islam1900/B.G2024/v-photos/B.jpeg

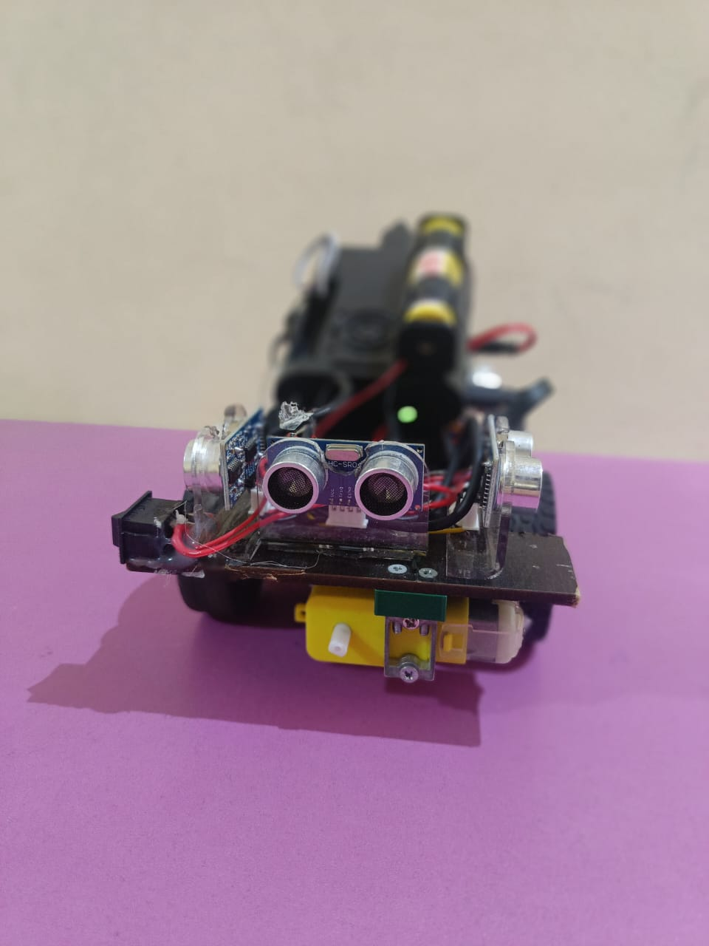
v-photos/B.jpeg
