islam1900/B.G2024/v-photos/R.jpeg

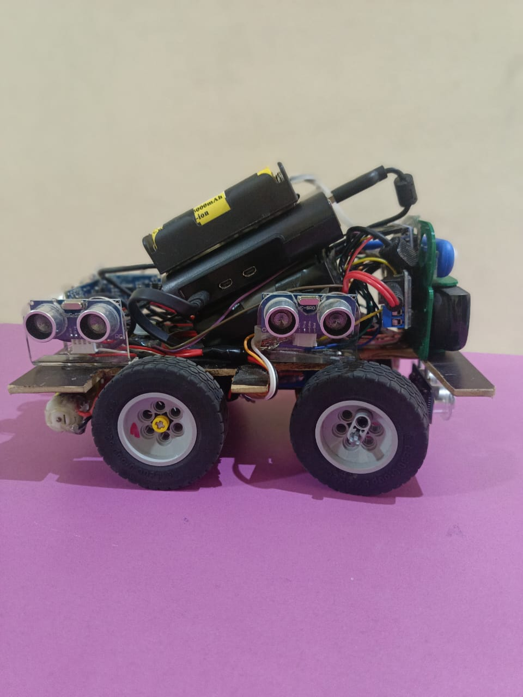
v-photos/R.jpeg
