islam1900/B.G2024/other/flow chart.jpeg

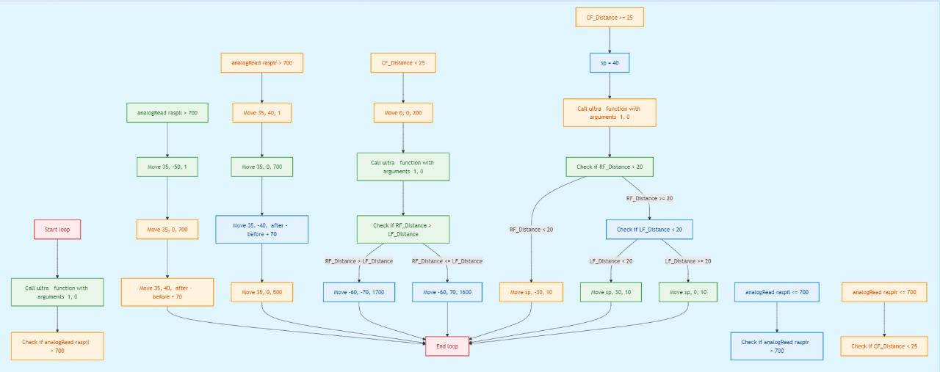
other/flow chart.jpeg
