islam1900/B.G2024/schemes/WhatsApp Image 2024-10-04 at 12.02.47 PM.jpeg

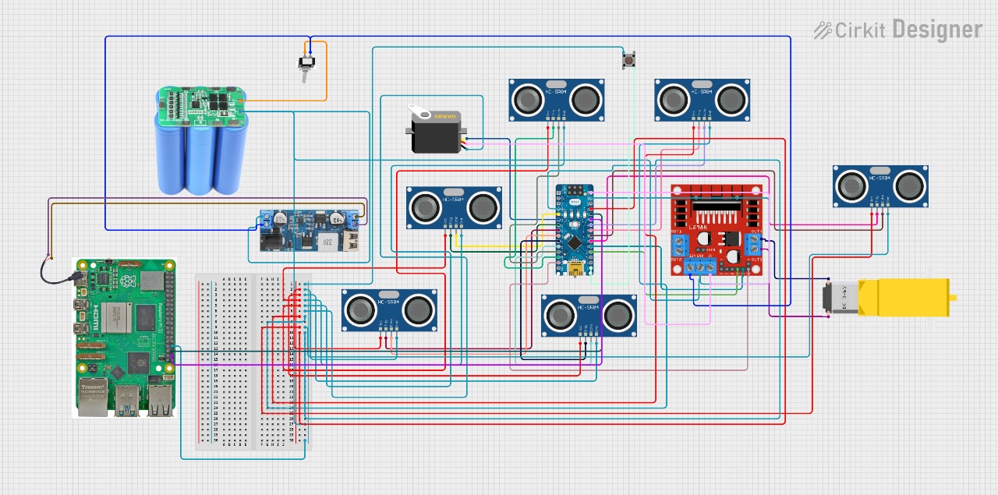
schemes/WhatsApp Image 2024-10-04 at 12.02.47 PM.jpeg
