islam1900/B.G2024/t-photos/WhatsApp Image 2024-10-04 at 3.51.35 PM.jpeg

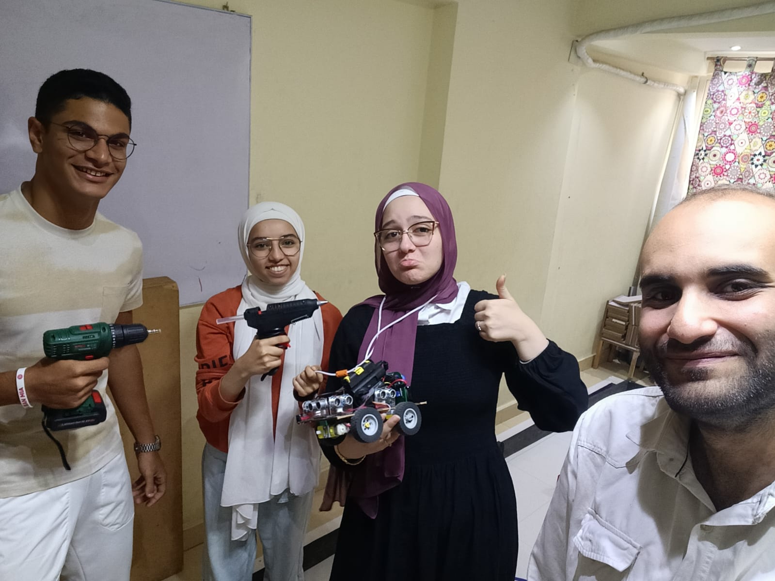
t-photos/WhatsApp Image 2024-10-04 at 3.51.35 PM.jpeg
