islam1900/B.G2024/v-photos/D.jpeg

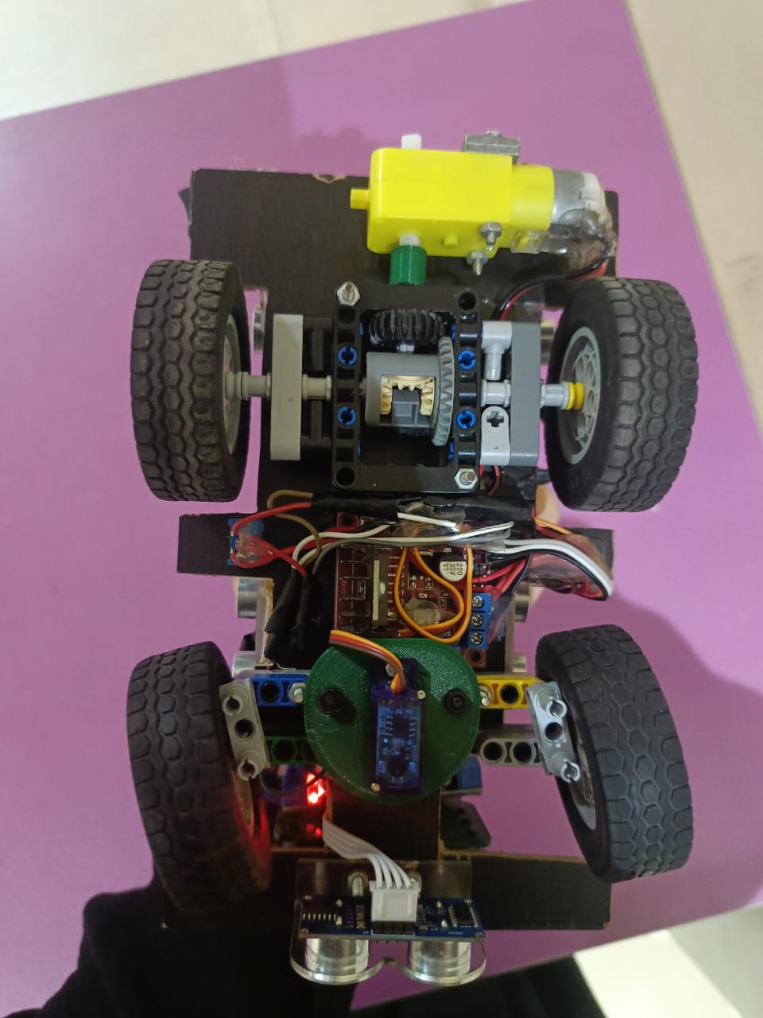
v-photos/D.jpeg
