islam1900/B.G2024/v-photos/F.jpeg

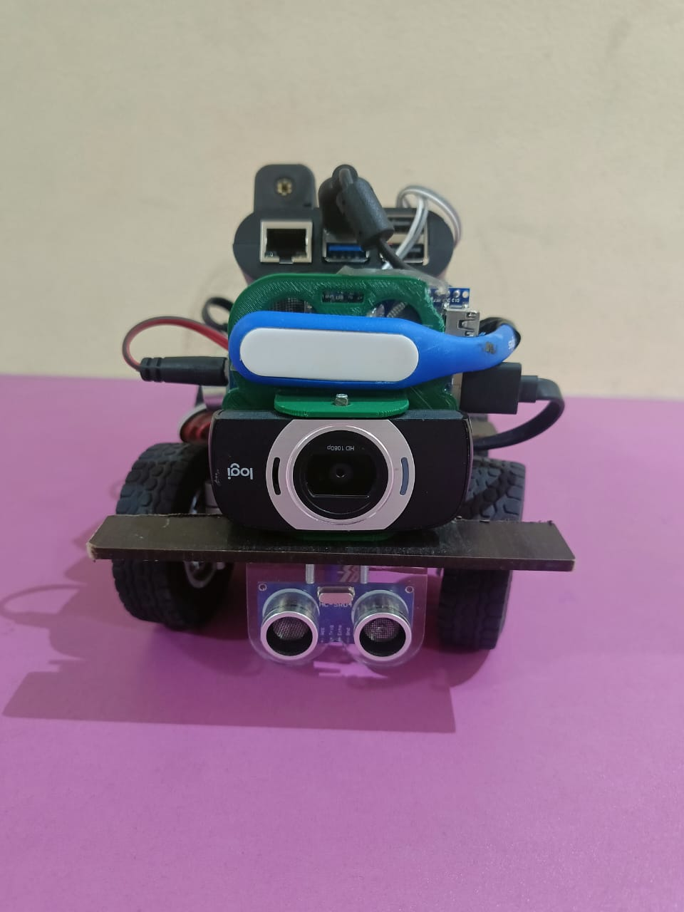
v-photos/F.jpeg
