islam1900/B.G2024/v-photos/L.jpeg

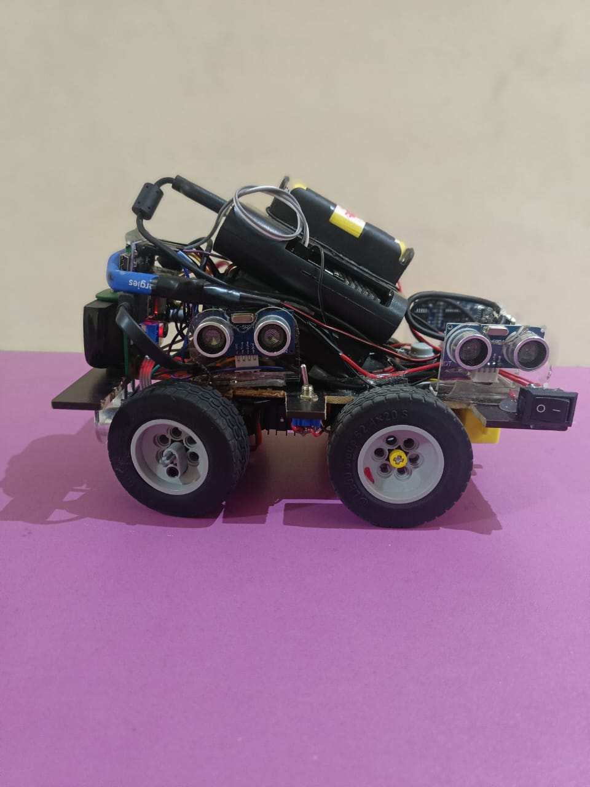
v-photos/L.jpeg
