islam1900/B.G2024/v-photos/T.jpeg

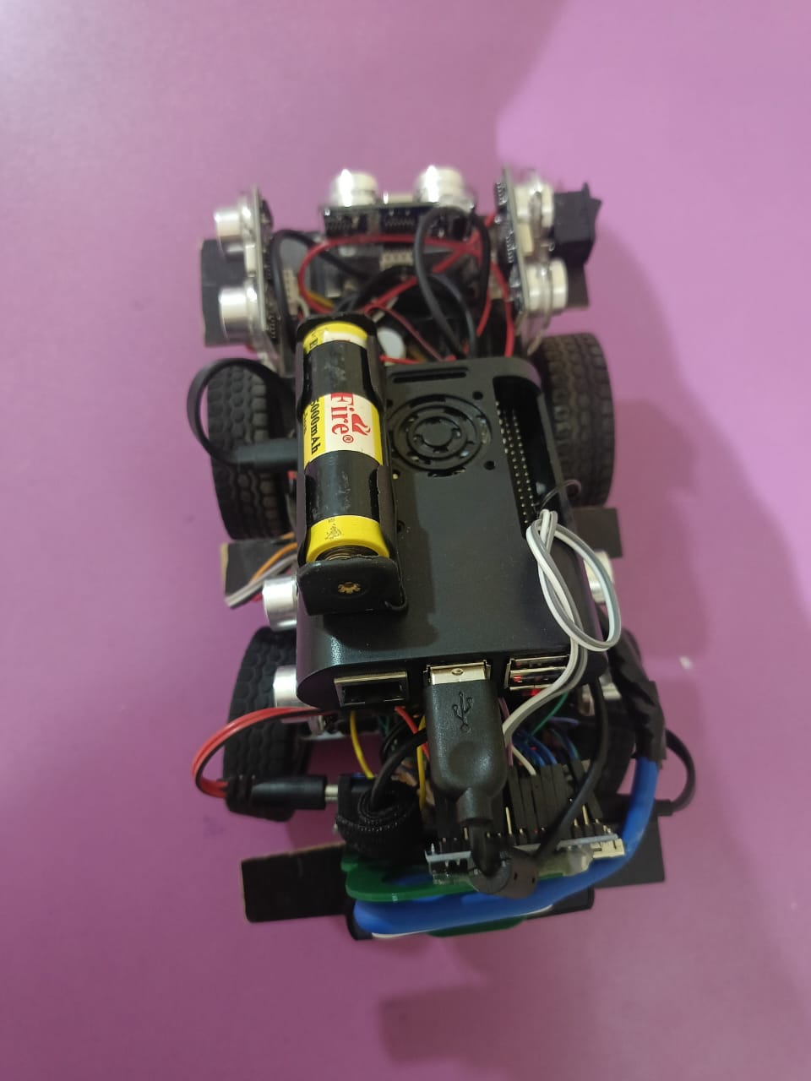
v-photos/T.jpeg
