islam1900/B.G2024/(list of files, cad)

Other CAD files:
models/dif-coupler V3.ipt
models/motor spacer.ipt
models/servo mount V3.ipt
models/test arm V3.ipt
